Cybernetic-Enhancement-Technologies/transradial_development/ECAD/Altium/SoM BaseBoard Prototype V0/Project Outputs for Free Documents - Latest/BOM/Bill of Materials-SoM BaseBoard Prototype V0.xlsx

Line # | Name | Description | Designator | Revision ID | Revision State | Revision Status | Quantity | PartNumber | Part Number | Manufacturer_Part_Number | Manufacturer Part Number | Manufacturer 1 | Manufacturer Part Number 1 | Manufacturer Lifecycle 1 | Supplier 1 | Supplier Part Number 1 | Supplier Unit Price 1 | Supplier Subtotal 1
 | C0603X104K5RACTU | CAP CER 0.1UF 50V X7R 0603 | C1, C3, C6, C17, C18, C22, C25 | CMP-2006-03300-2 | New From Design | Up to date | 7 |  |  |  | C0603X104K5RACTU | KEMET | C0603X104K5RACTU | Volume Production | Digi-Key | 399-7969-1-ND | 0.149 | 4.17
 | GRM21BR60J226ME39L | Chip Multilayer Ceramic Capacitors for General Purpose, 0805, 22uF, X5R, 15%, 20%, 6.3V | C2, C7, C8 | CMP-2007-03385-2 | New From Design | Up to date | 3 |  |  |  |  | Murata | GRM21BR60J226ME39L | Not Recommended for New Design | Digi-Key | 490-1719-1-ND | 0.314 | 3.77
 | C0805C105K4PACTU |  | C4, C19, C24 | CMP-1036-04746-2 | Released | Up to date | 3 |  | C0805C105K4PACTU |  |  | TDK | C2012X7R1C105K/1.25 | End of Life | Arrow Electronics | C2012X7R1C105K/1.25 | 0.0979 | 1.17
 | GRM31CR60J476ME19L | Chip Multilayer Ceramic Capacitors for General Purpose, 1206, 47uF, X5R, 15%, 20%, 6.3V | C5 | CMP-2000-06344-2 | New From Design | Up to date | 1 |  |  |  |  | Murata | GRM31CR60J476ME19L | Not Recommended for New Design | Digi-Key | 490-3907-1-ND | 0.82 | 3.28
 | C2012X7R1A106K125AC | Multilayer Ceramic Chip Capacitor, 10 uF, +/- 10%, 10 V, -55 to 125 degC, 0805 (2012 Metric), RoHS, Tape and Reel | C9, C10, C12, C14, C15, C16, C23 | CMP-2000-05452-1 | Released | Up to date | 7 |  |  |  |  | TDK | C2012X7R1A106K125AC | Volume Production
 | ECA-1JHG471 | Aluminum Electrolytic Capacitor (Radial Lead Type), 470 uF, 63 V, -55 to 105 degC, 2-Pin THD, RoHS, Bulk | C11 | CMP-1665-00014-4 | Released | Up to date | 1 |  |  |  |  | Panasonic | ECA-1JHG471 | Volume Production | Allied Electronics | 70255904 | 0.887 | 88.7
 | UWX1E101MCL1GB | CAP ALUM 100UF 20% 25V SMD | C13 | CMP-12462-000012-1 | New From Design | Up to date | 1 |  |  |  |  | Nichicon | UWX1E101MCL1GB | Volume Production | Allied Electronics | 70409966 | 0.167 | 104.38
 | 06035C102KAT2A |  | C20, C21, C26, C27 | CMP-2006-04378-1 | Released | Up to date | 4 |  | 06035C102KAT2A |  |  | Kyocera AVX | 06035C102KAT2A | Volume Production | Digi-Key | 478-1215-1-ND | 0.045 | 0.72
 | SMBJ5.0A-TR | TVS DIODE 5V 13.4V SMB | D1 | CMP-12225-000019-1 | New From Design | Up to date | 1 |  |  |  | SMBJ5.0A-TR | STMicroelectronics | SMBJ5.0A-TR | Volume Production | Digi-Key | 497-3144-1-ND | 0.42 | 1.68
 | 210-P92-20GBEG | SOCKET 2X20 100-MIL STRAIGHT SMT | J1 |  | Not managed |  | 1 |  |  |  |  |  |  |  | Samtec | 210-P92-20GBEG
 | USB4085-GF-A | CONN RCPT USB2.0 TYPEC 16POS | J2, J3 | CMP-196119-000001-1 | New From Design | Up to date | 2 |  |  |  | USB4085-GF-A | Global Connector Technology | USB4085-GF-A | Volume Production | Digi-Key | 2073-USB4085-GF-ACT-ND | 0.94 | 7.52
 | 87520-0010BLF |  | J4 |  | Not managed |  | 1 |  |  |  |  | Amphenol ICC / FCI | 87520-0010BLF | Unknown | Digi-Key | 609-1045-ND | 0.84 | 3.36
 | 0.1 1x3 Header |  | J6, J7, J10, J11 |  | Not managed |  | 4
 | SJ1-3523N | Connector | J8, J12 |  | Not managed |  | 2 |  |  | SJ1-3523N |  | CUI | SJ1-3523N | Volume Production | Digi-Key | CP1-3523N-ND | 0.75 | 6
 | DF40HC(3.0)-100DS-0.4V(51) | CONN HDR 100POS 0.4MM SMD GOLD | J1310, J1311, J1312 |  | Not managed |  | 3 |  |  |  |  | Hirose | DF40C-100DP-0.4V(51) | Volume Production | Digi-Key | H11614CT-ND | 1.42 | 17.05
 | 2.2uH 1.7A | Inductor NRH2412T2R2MNGH | L1 |  | Not managed |  | 1 |  |  | NRH2412T2R2MNGH |  | Taiyo Yuden | NRH2412T2R2MNGH | Volume Production | Digi-Key | 587-3443-1-ND | 0.24 | 0.96
 | 150080SS75000 | SMD mono-color Chip LED, WL-SMCW, Super Red | LED1 | CMP-1426-00010-1 | Released | Up to date | 1 | 150080SS75000 |  |  |  | Wurth Electronics | 150080SS75000 | Volume Production | Digi-Key | 732-4985-1-ND | 0.18 | 0.72
 | 150080GS75000 | SMD mono-color Chip LED, WL-SMCW, Green | LED2 | CMP-1426-00007-1 | Released | Up to date | 1 | 150080GS75000 |  |  |  | Wurth Electronics | 150080GS75000 | Volume Production | Digi-Key | 732-4983-1-ND | 0.18 | 0.72
 | Servo Motor |  | M1, M2, M3, M4, M5, M6 |  | Not managed |  | 6
 | B2B-PH-SM4-TB(LF)(SN) | Male Header, Pitch 2 mm, 1 x 2 Position, Height 6.6 mm, RoHS, Tape and Reel | P1 | CMP-2000-05163-1 | Released | Up to date | 1 |  |  |  |  | JST | B2B-PH-SM4-TB(LF)(SN) | Volume Production
 | 5-146280-2 | Male Header, Pitch 2.54 mm, 1 x 2 Position, Height 8.21 mm, Tail Length 3.05 mm, -65 to 105 degC, RoHS, Bulk | P2 | CMP-2000-07492-1 | Released | Up to date | 1 |  |  |  |  | TE Connectivity | 5-146280-2 | Volume Production | Mouser | 571-5-146280-2 | 0.45 | 1.8
 | PMF250XNEX | MOSFET (N-Channel) | Q1, Q2 |  | Not managed |  | 2 |  |  | PMF250XNEX |  | Nexperia | PMF250XNEX | Unknown | Mouser | 771-PMF250XNEX | 0.262 | 2.62
 | RC0805FR-0710KL | Chip Resistor, 10 KOhm, +/- 1%, 0.125 W, -55 to 155 degC, 0805 (2012 Metric), RoHS, Tape and Reel | R1, R9, R12, R13, R15, R16, R21, R22, R27, R28, R31, R32, R33, R34, R35, R36, R37, R38 | CMP-1659-00013-4 | Released | Up to date | 18 |  |  |  |  | Yageo | RC0805FR-0710KL | Volume Production | Digi-Key | 311-10.0KCRCT-ND | 0.0169 | 1.69
 | CRCW08055K10FKEA | RES Thick Film, 5.1kΩ, 1%, 0.125W, 100ppm/°C, 0805 | R2, R4, R6, R7 | CMP-2001-04024-2 | New From Design | Up to date | 4 |  |  |  |  | Vishay | CRCW08055K10FKEA | Volume Production | Digi-Key | 541-5.10KCCT-ND | 0.067 | 1.07
 | RC0805FR-071KL | Chip Resistor, 1 KOhm, +/- 1%, 125 mW, -55 to 155 degC, 0805 (2012 Metric), RoHS, Tape and Reel | R3, R8 | CMP-2100-03671-1 | Released | Up to date | 2 |  |  |  |  | Yageo | RC0805FR-071KL | Volume Production | Digi-Key | 311-1.00KCRCT-ND | 0.042 | 0.42
 | RC1206JR-070RL | RES SMD 0 OHM JUMPER 1/4W 1206 | R5, R11, R17, R18, R25 | CMP-2100-03681-2 | New From Design | Up to date | 5 |  |  |  | RC1206JR-070RL | Yageo | RC1206JR-070RL | Volume Production | Digi-Key | 311-0.0ERCT-ND | 0.04 | 1
 | CRCW080520K0FKEA | RES Thick Film, 20kΩ, 1%, 0.125W, 100ppm/°C, 0805 | R10 | CMP-2001-03667-2 | New From Design | Up to date | 1 |  |  |  |  | Vishay | CRCW080520K0FKEA | Volume Production | Arrow Electronics | CRCW080520K0FKEA | 0.0998 | 0.3992
 | RC0603FR-07100KL | RES SMD 100K OHM 1% 1/10W 0603 | R19, R20, R23, R24, R26 | CMP-2100-03662-2 | Released | Up to date | 5 |  |  |  |  | Yageo | RC0603FR-07100KL | Volume Production | Digi-Key | 311-100KHRCT-ND | 0.024 | 0.48
 | KTS1681AEUZ-TR | Switch | S1 |  | Not managed |  | 1 |  |  | KTS1681AEUZ-TR |  | Kinetic Technologies | KTS1681AEUZ-TR | Unknown | Mouser | 389-KTS1681AEUZTR | 0.76 | 3.04
 | TestPad |  | TP1, TP2, TP3, TP4, TP5, TP6, TP7, TP8, TP9, TP10, TP11, TP12, TP13, TP14, TP15, TP16, TP17, TP18, TP19, TP20, TP21, TP22, TP23, TP24, TP25, TP26, TP27, TP28, TP29, TP30, TP31, TP32, TP33, TP34, TP35, TP36, TP37 |  | Not managed |  | 37
 | LM3671MF-3.3/NOPB | IC REG BUCK 3.3V 600MA SOT23-5 | U1 | CMP-0063-01132-4 | Released | Up to date | 1 |  |  |  |  | Texas Instruments | LM3671MF-3.3/NOPB | Volume Production | Mouser | 926-LM3671MF-3.3NOPB | 1.62 | 6.48
 | AP22653W6-7 | LOAD SWITCH,SOT26,T&R,3K | U2 | CMP-12749-000002-1 | New From Design | Up to date | 1 |  |  |  |  | Diodes | AP22653W6-7 | Unknown
 | ADS1015IDGST | IC ADC 12BIT SIGMA-DELTA 10VSSOP | U3 | CMP-0003-00377-3 | New From Design | Up to date | 1 |  |  |  |  | Texas Instruments | ADS1015IDGST | Volume Production
 | PCA9685PW,112 | 16-Channel, 12-Bit PWM Fm+ I2C-Bus LED Controller, 2.3 to 5.5 V, -40 to 85 degC, 28-Pin TSSOP (SOT361-1), RoHS, Tape and Reel | U4 | CMP-1595-00004-2 | Released | Up to date | 1 | PCA9685 |  |  |  | NXP Semiconductors | PCA9685PW,112 | Volume Production
 | NX5427001Z | Crystal or Oscillator | Y1 |  | Not managed |  | 1 |  |  | NX5427001Z |  | Diodes | NX5427001Z | Unknown | Digi-Key | NX5427001ZDICT-ND | 4.57 | 18.28
