Cybernetic-Enhancement-Technologies/transradial_development/(list of files, cad)

Other CAD files:
ECAD/Altium/SoM BaseBoard Prototype V0/Project Outputs for Free Documents - Latest/STEPandDXF Manual Exports/SoM BaseBoard Limbotics Prototype V0PcbDoc.DWG
