Cybernetic-Enhancement-Technologies/transradial_development/(threads)

Thread 4 (2021-03-25):

Add manual terminal event that can safely exit main program

jered-b, 2021-03-25:
https://github.com/Cybernetic-Enhancement-Technologies/transradial_development/blob/bbd427a37b41c3b04e2b4fbdbbd23f0511a7a25d/main_program.py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

jered-b, 2021-03-25:
Solved this using keyboard interrupt, pull request created.

Closed 2021-03-25.

Thread 10 (2021-03-27):

Add minimum number of frames across timespan of detection to qualify changing class attribute

jered-b, 2021-03-27:
https://github.com/Cybernetic-Enhancement-Technologies/transradial_development/blob/85f374cca53185f1cab10da0f46d26b2dd871e72/Camera_Interpreter/camera.py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

jered-b, 2021-04-06:
Instead going with simple time delay

Closed 2021-04-06.

Thread 9 (2021-03-27):

Add minimum number of detected frames over timespan before changing class attribute

jered-b, 2021-03-27:
https://github.com/Cybernetic-Enhancement-Technologies/transradial_development/blob/f93b8732a72df827598e175252912fcb6db20882/Camera_Interpreter/camera.py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

jered-b, 2021-03-27:
Accidentally opened, please check issue #10

Closed 2021-03-27.
