Cybernetic-Enhancement-Technologies/transradial_development/ECAD/Altium/SoM BaseBoard Prototype V0/Project Outputs for Free Documents - Latest/SoM BaseBoard Prototype V0.pdf

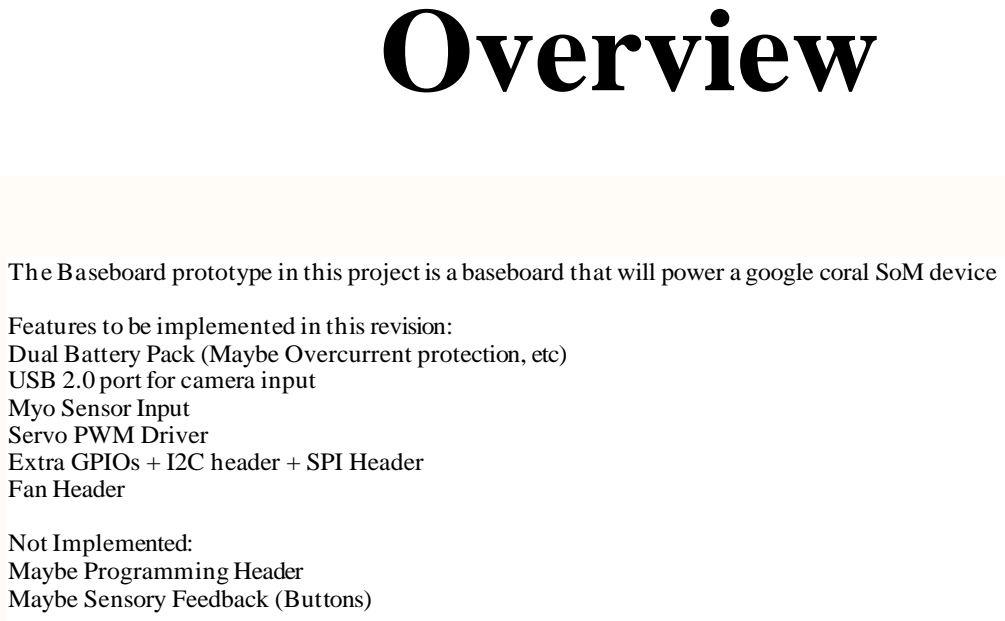
[picture p1: page 1]

DWG NO: | REV:

THIS DOCUMENT AND THE DATA DISCLOSED HEREIN OR HEREWITH IS THE PROPERTY OF ALTIUM LIMITED AND MAY BE FREELY DISTRIBUTED IN WHOLE. NO RIGHTS ARE RESERVED OR EXPRESS OR IMPLIED WARANTEE GIVEN. | | REVISION | DESCRIPTION | DATE | APPROVED

The Baseboard prototype in this project is a baseboard that will power a google coral SoM device

Features to be implemented in this revision:
Dual Battery Pack (Maybe Overcurrent protection, etc)
USB 2.0 port for camera input
Myo Sensor Input
Servo PWM Driver
Extra GPIOs + I2C header + SPI Header
Fan Header

Not Implemented:
Maybe Programming Header
Maybe Sensory Feedback (Buttons)

DATE | PROJECT | * * APPROVALS * *

ENG: *
CHK: * | | TITLE *

DSN: *

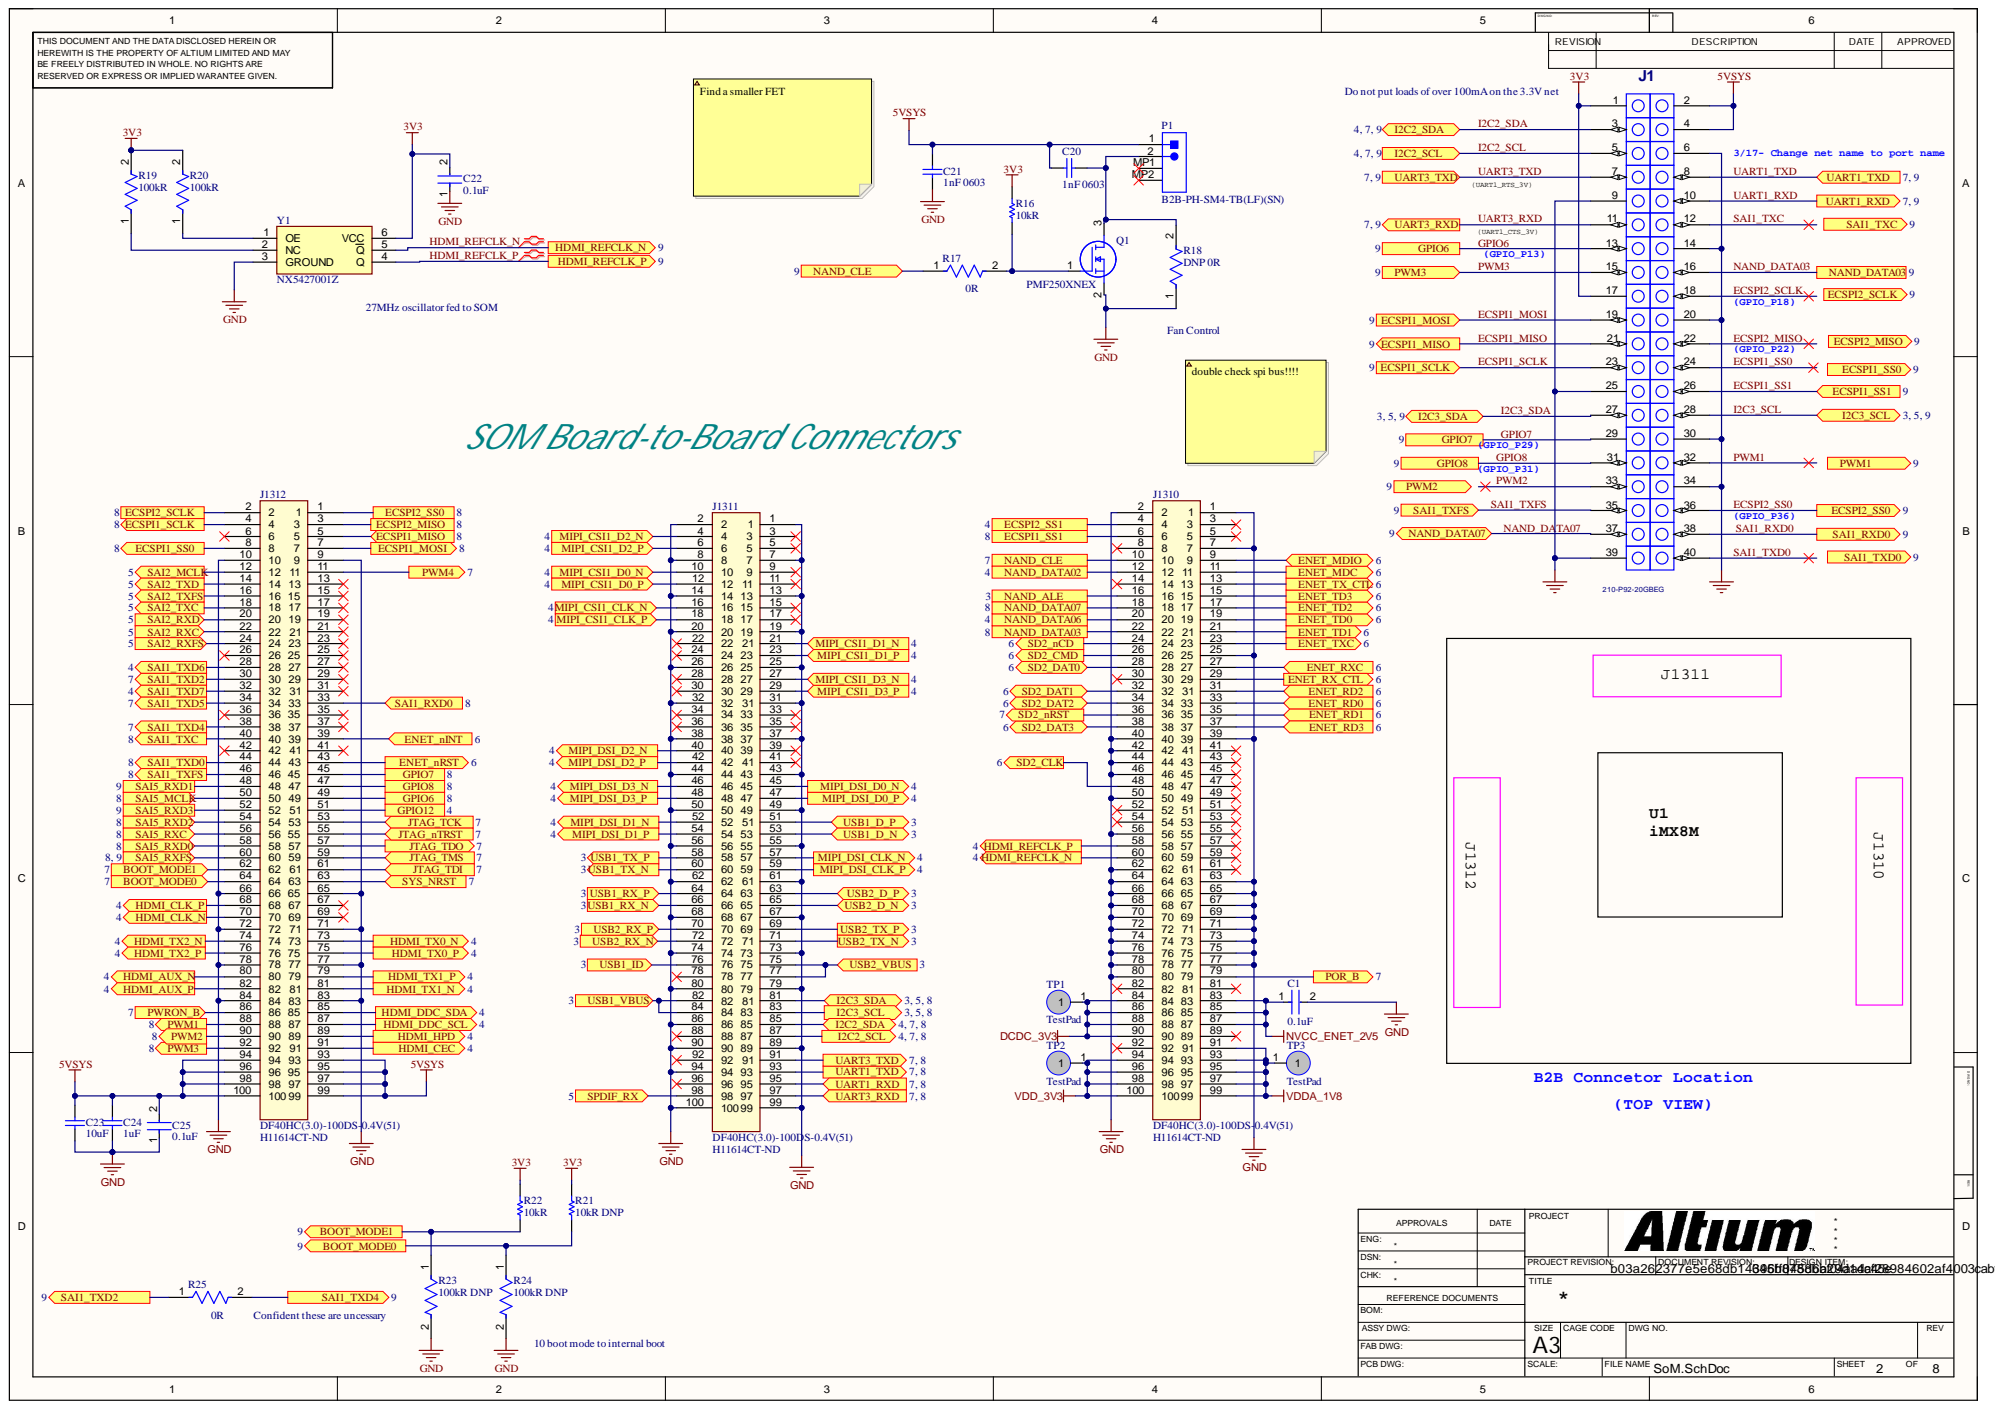
[picture p2: page 2]

RESERVED OR EXPRESS OR IMPLIED WARANTEE GIVEN.

Do not put loads of over 100mAon the 3.3V net

3/17- Change net name to port name
UART1_TXD

9 | | 10 | UART1_RXD

11 | | 12 | SAI1_TXC

27MHz oscillator fed to SOM

double check spi bus!!!!

27 | 28 | I2C3_SCL

SOM Board-to-Board Connectors

29 | 30 | PWM1

35 | 36
37 39 | 38 | (GPIO_P36) SAI1_RXD0

DATE | PROJECT | * * APPROVALS * *

ENG: *

Confident these are uncessary

10 boot mode to internal boot

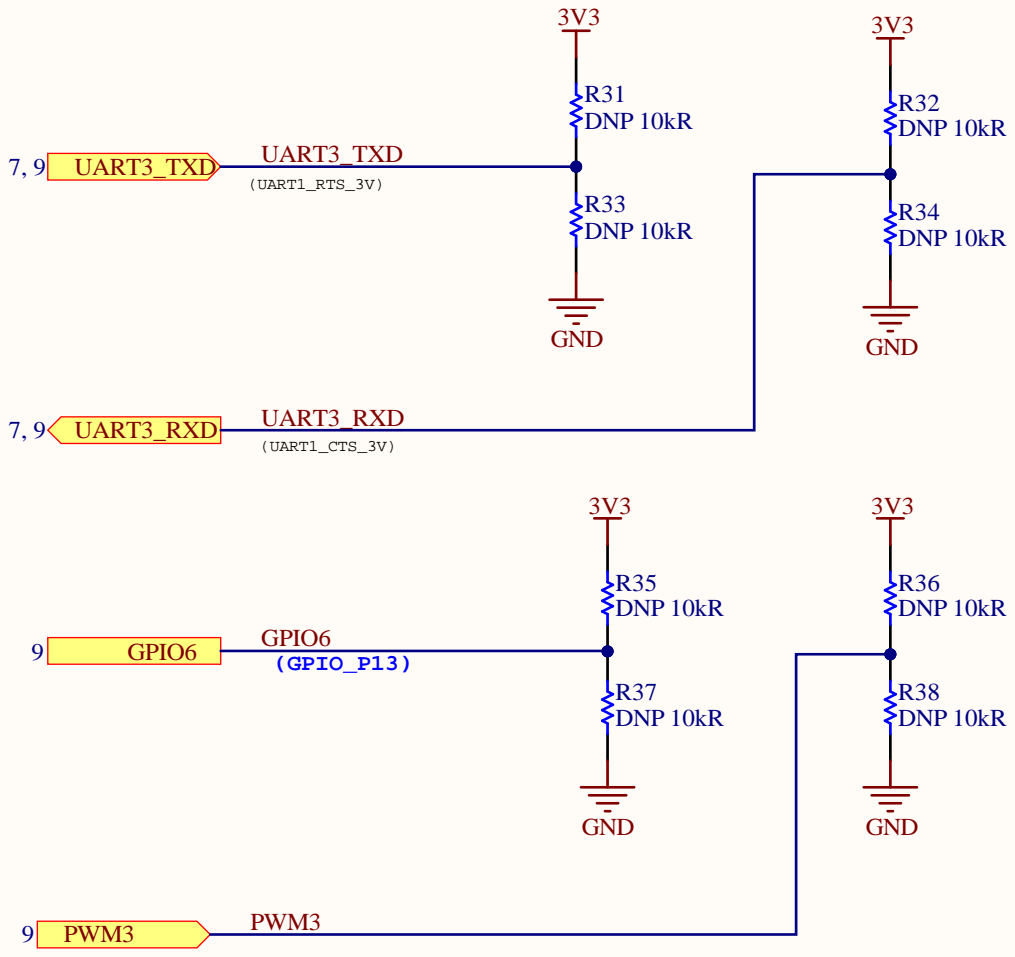
[picture p3: page 3]

RESERVED OR EXPRESS OR IMPLIED WARANTEE GIVEN.

DATE | PROJECT | * * APPROVALS * *

ENG: *
CHK: * | | TITLE *

DSN: *

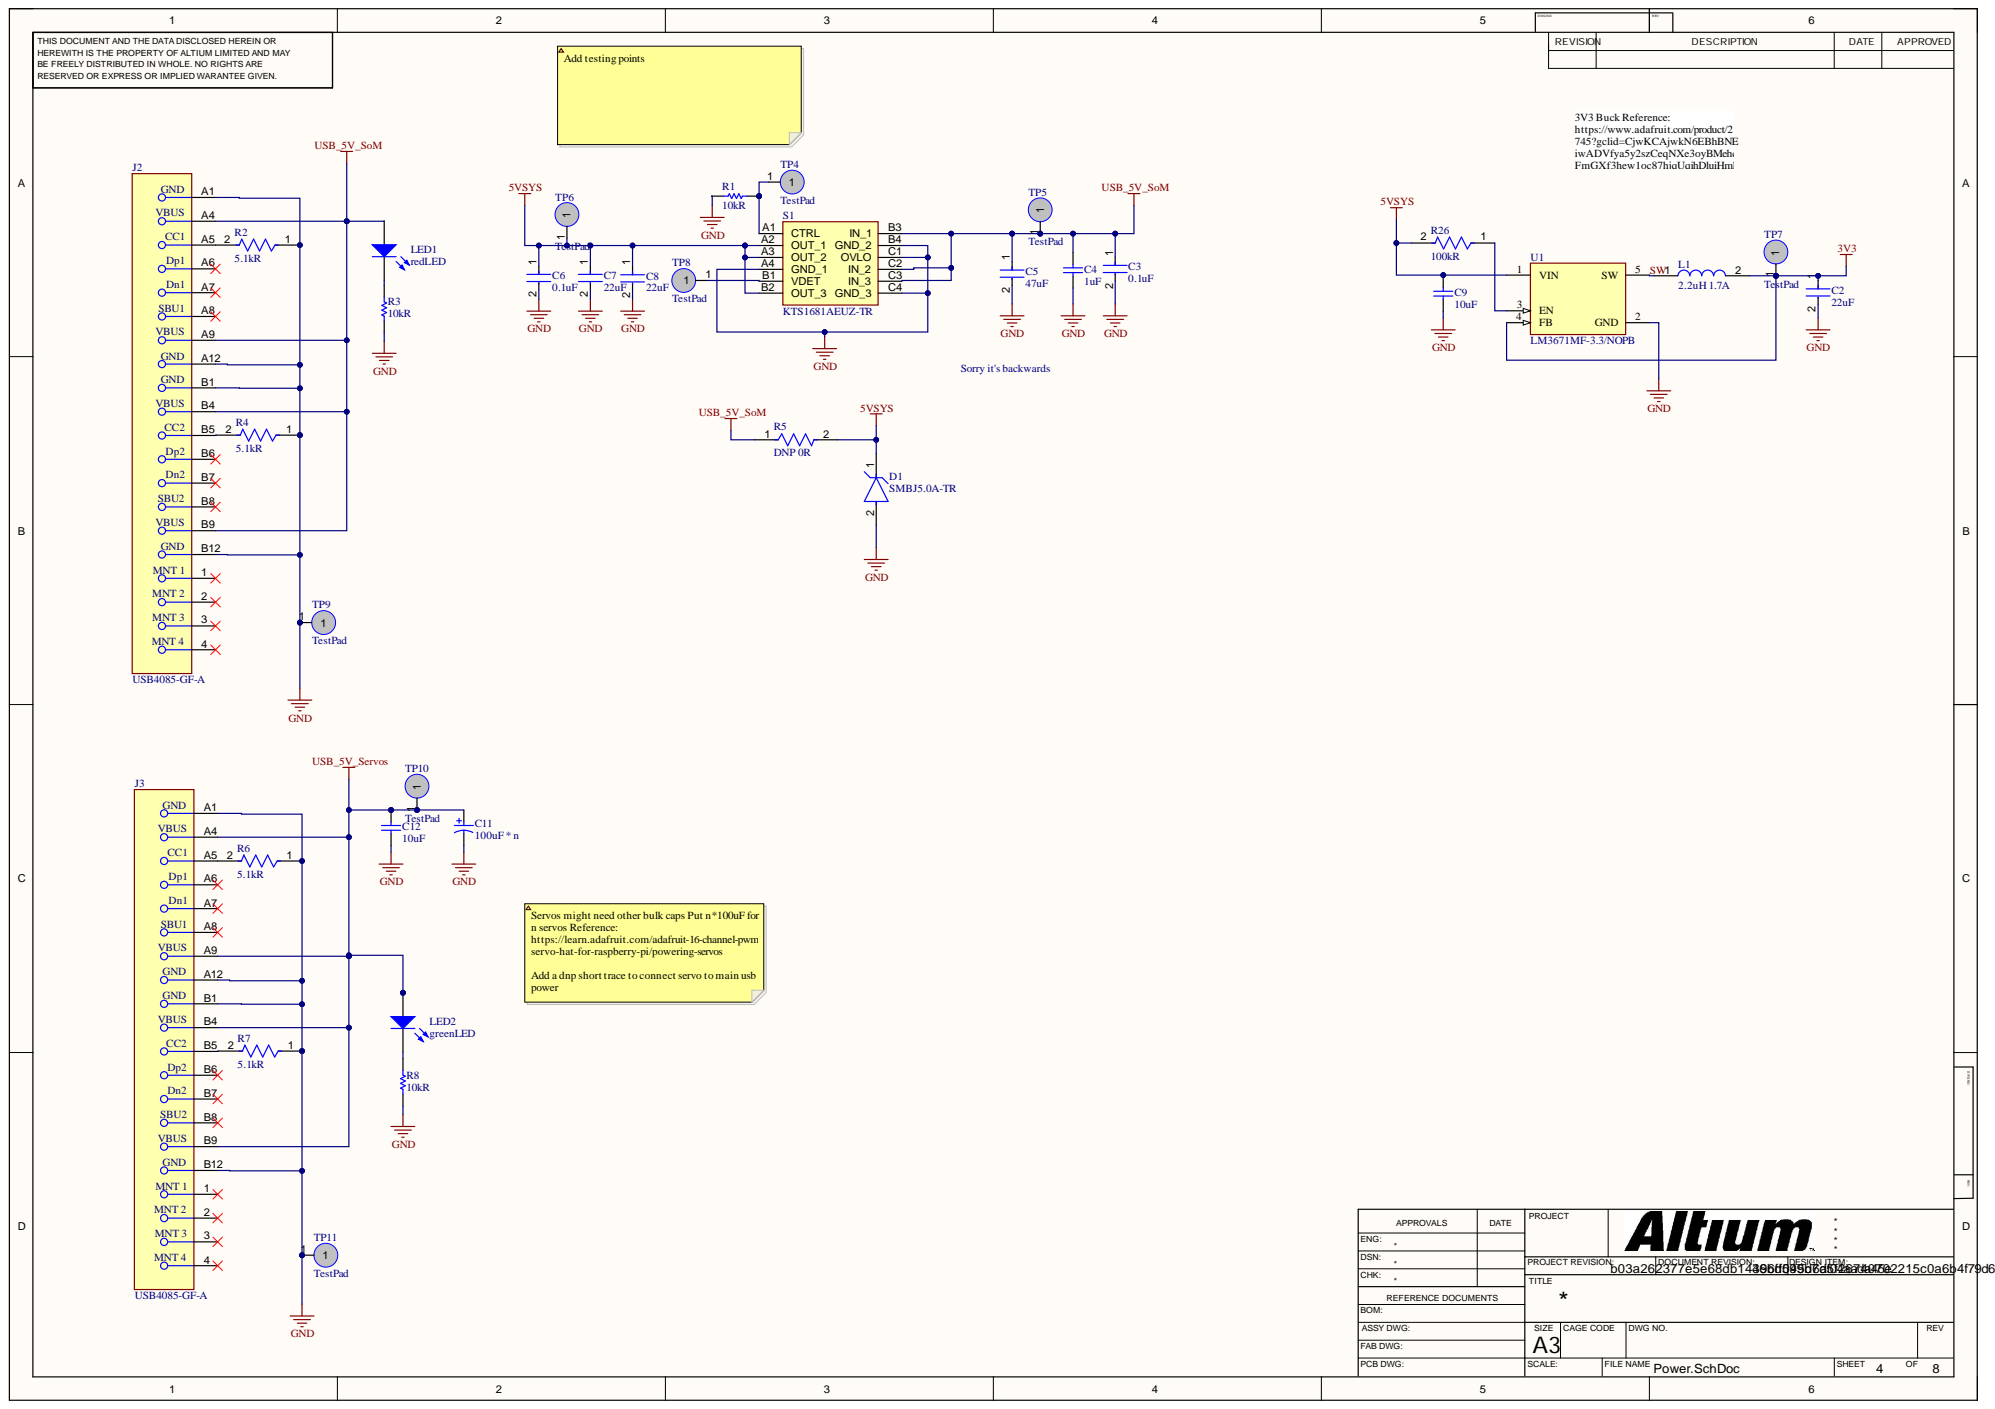
[picture p4: page 4]

RESERVED OR EXPRESS OR IMPLIED WARANTEE GIVEN.

Servos might need other bulk caps Put n*100uF for
n servos Reference:
https://learn.adafruit.com/adafruit-16-channel-pwm-
servo-hat-for-raspberry-pi/powering-servos

Add a dnp short trace to connectservo to main usb
power

DATE | PROJECT | * * APPROVALS * *

ENG: *
CHK: * | | TITLE *

DSN: *

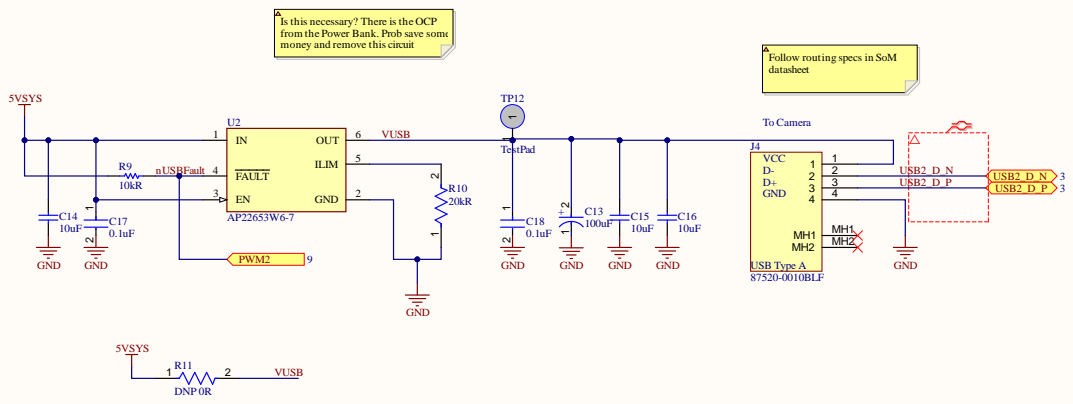
[picture p5: page 5]

RESERVED OR EXPRESS OR IMPLIED WARANTEE GIVEN.

Is this necessary? There is the OCP
from the Power Bank. Prob save some
money and remove this circuit

Follow routing specs in SoM
datasheet

DATE | PROJECT | * * APPROVALS * *

ENG: *
CHK: * | | TITLE *

DSN: *

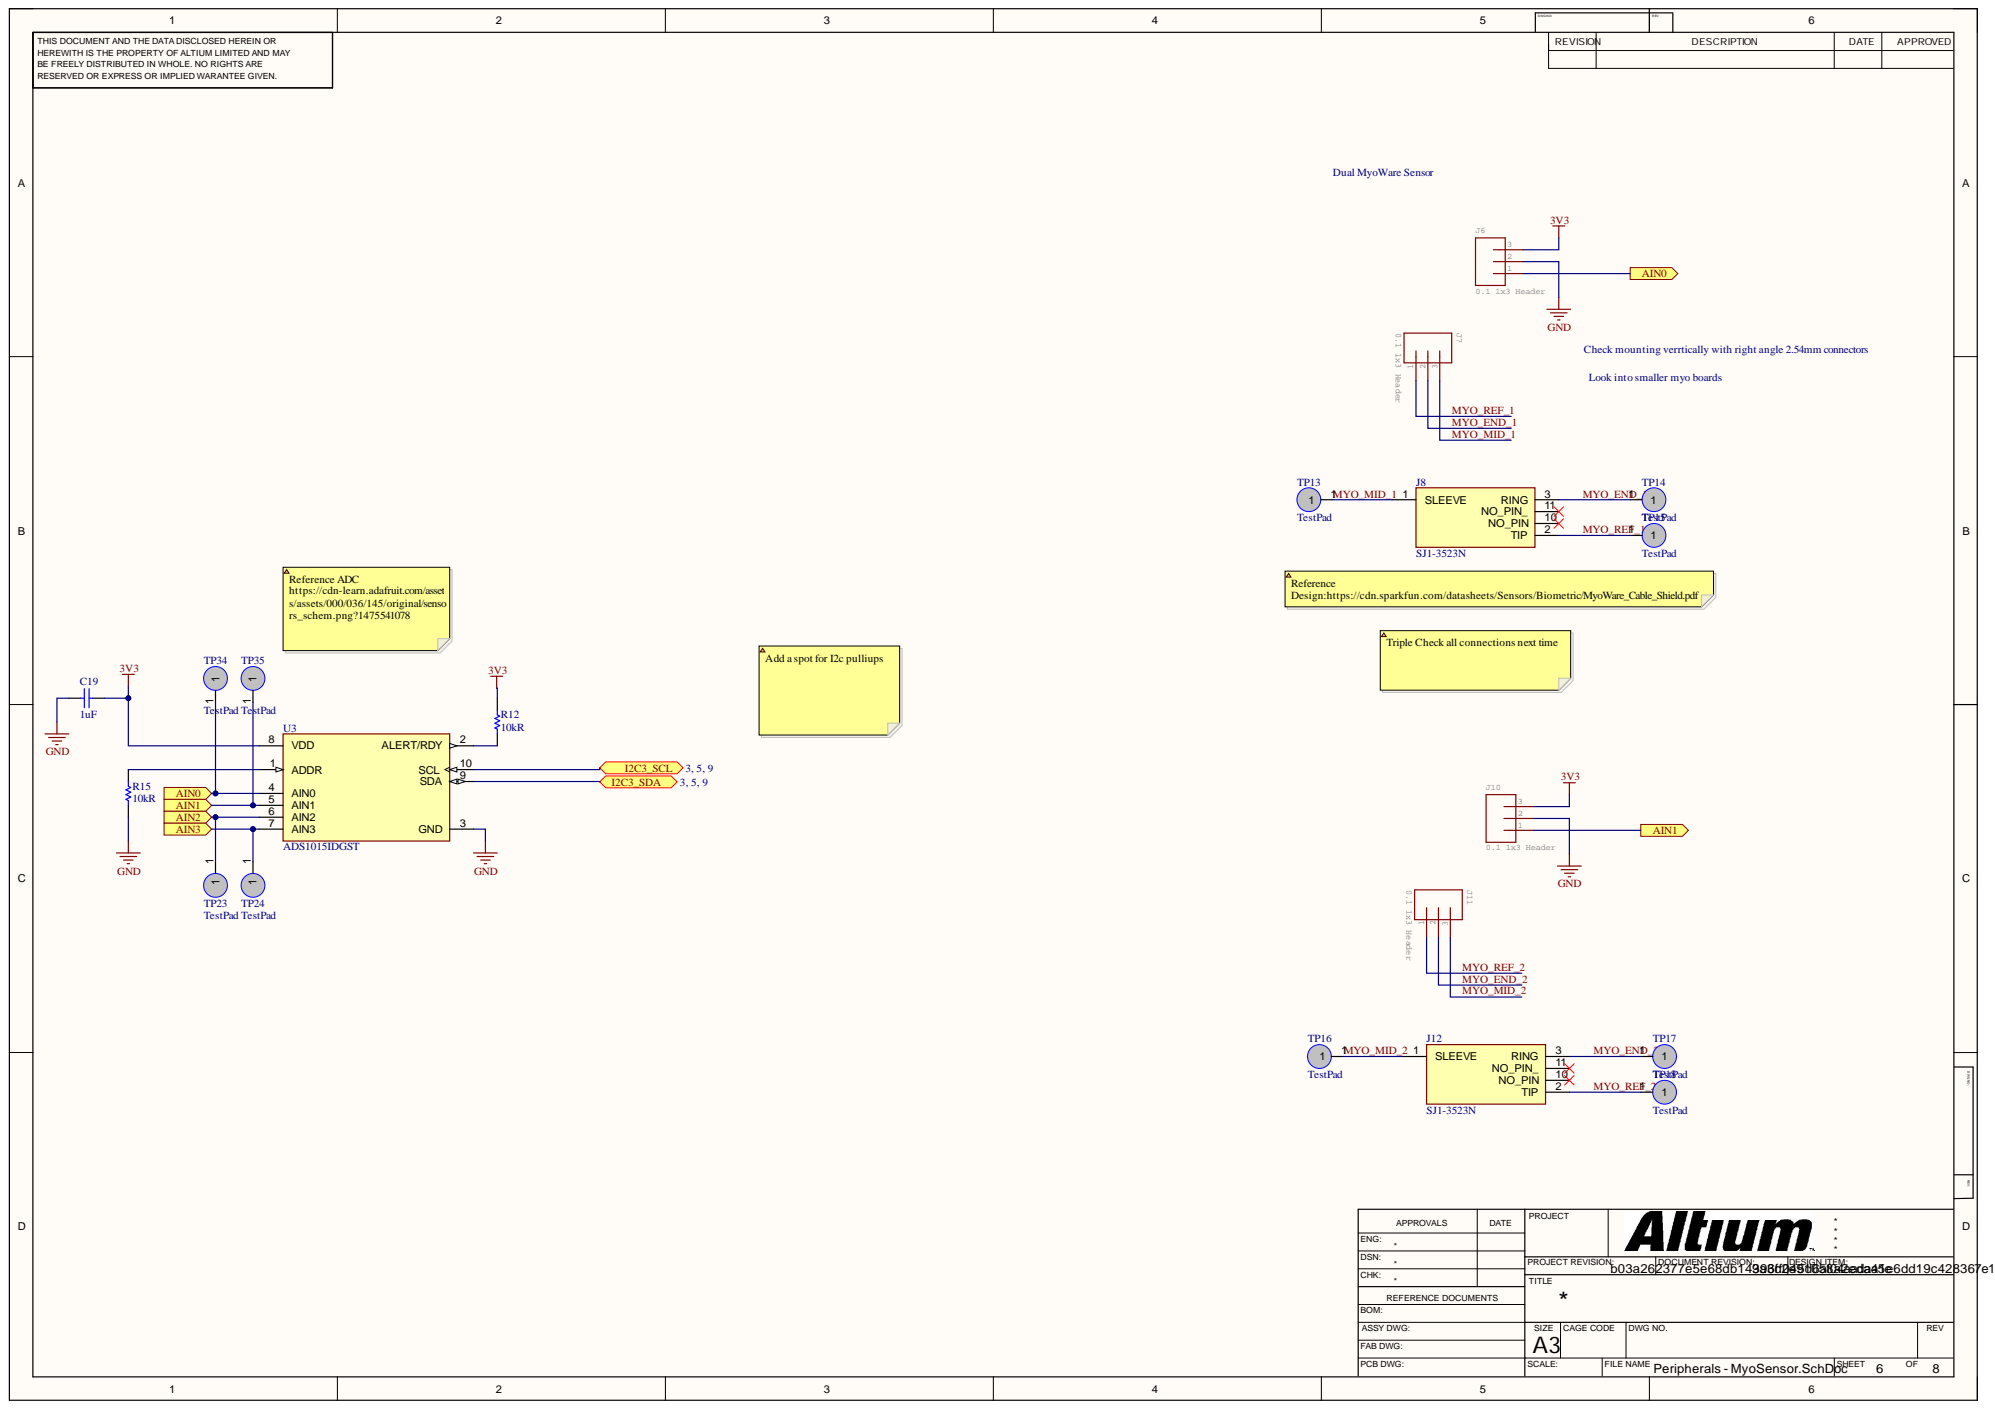
[picture p6: page 6]

RESERVED OR EXPRESS OR IMPLIED WARANTEE GIVEN.

Check mounting verrtically with right angle 2.54mm connectors

Look into smaller myo boards

Reference ADC
https://cdn-learn.adafruit.com/asset
s/assets/000/036/145/original/senso
rs_schem.png?1475541078

Reference
Design:https://cdn.sparkfun.com/datasheets/Sensors/Biometric/MyoWare_Cable_Shield.pdf

Triple Check all connections next time

Add a spot for I2c pulliups

DATE | PROJECT | * * APPROVALS * *

ENG: *
CHK: * | | TITLE *

DSN: *

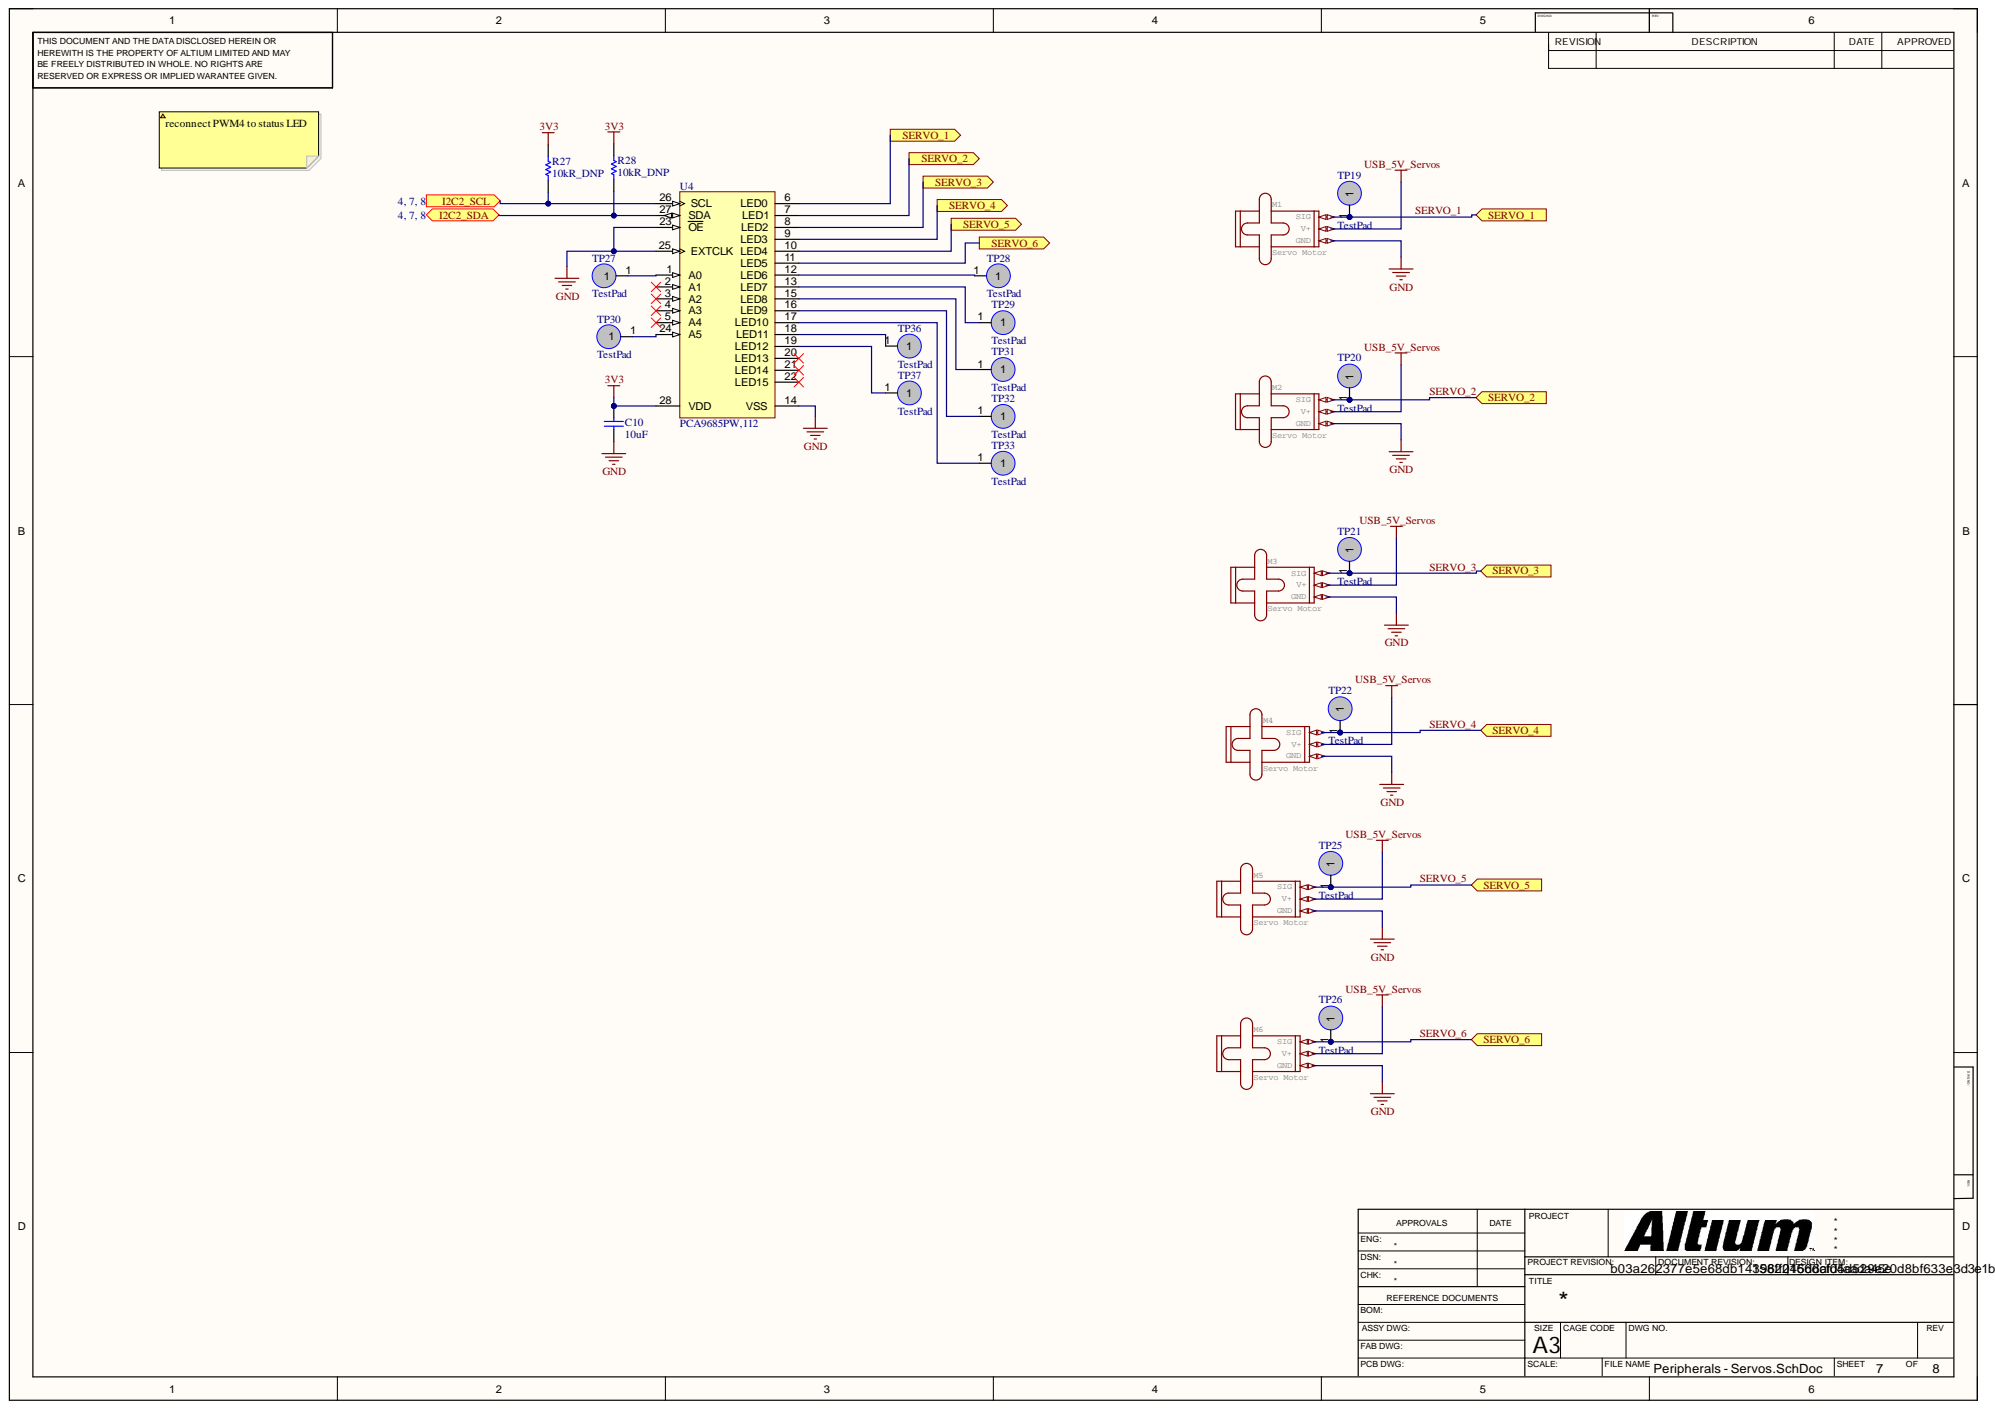
[picture p7: page 7]

RESERVED OR EXPRESS OR IMPLIED WARANTEE GIVEN.

reconnect PWM4 to status LED

DATE | PROJECT | * * APPROVALS * *

ENG: *
CHK: * | | TITLE *

DSN: *

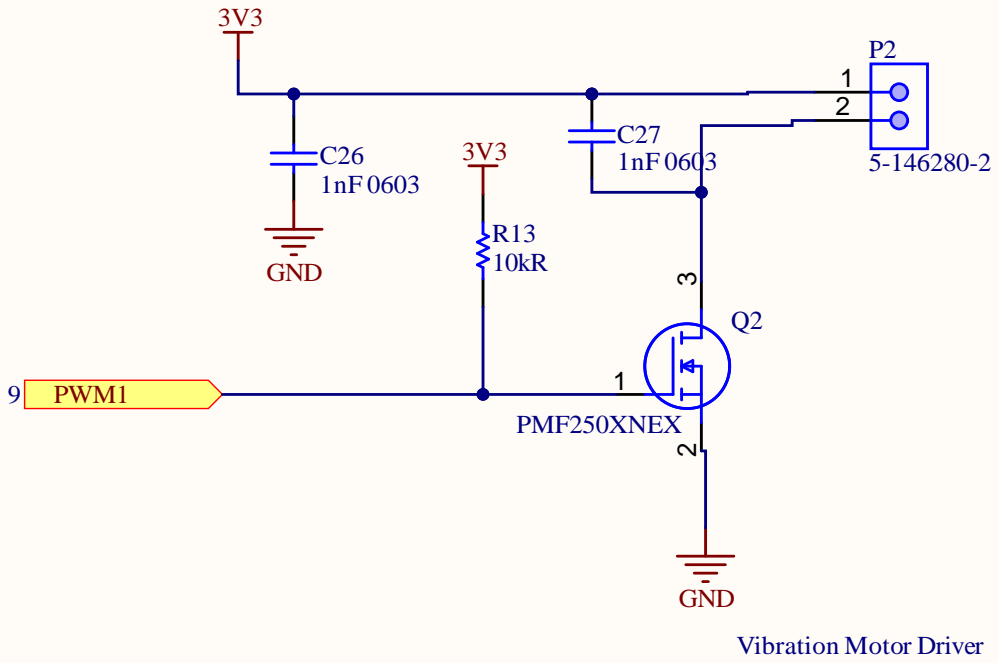
[picture p8: page 8]

THIS DOCUM ENT AND THE DATA DISCLOS ED HEREIN OR HERE WITH IS THE PROP ERT Y OF A LTIUM LIMIT ED AND M AY B E FRE E LY DIS TRIBUT ED IN WHOL E. NO RIGHT S ARE RE S ERV ED OR E X PRE S S OR IM P LIED W ARANT E E GIV EN. | | R E V I S I O | N D E S C R I P T I O N | D A T E | A P P R O V E D

A P PROV A L S | DAT E | PROJECT | ****

ENG: **
CHK : | | TIT L E *

DSN: | | PROJECT RE VISION: b 0 3 a 2 6 | DOCUM ENT RE VISION: 2 3 7 7 e 5 e 6 8 d b 1 4 53 89 86 bff0e | DE SIGN IT E M : c4f05d567a2f 03 4d a7acdda6465ee5 c 4 c b 8 3 e 6

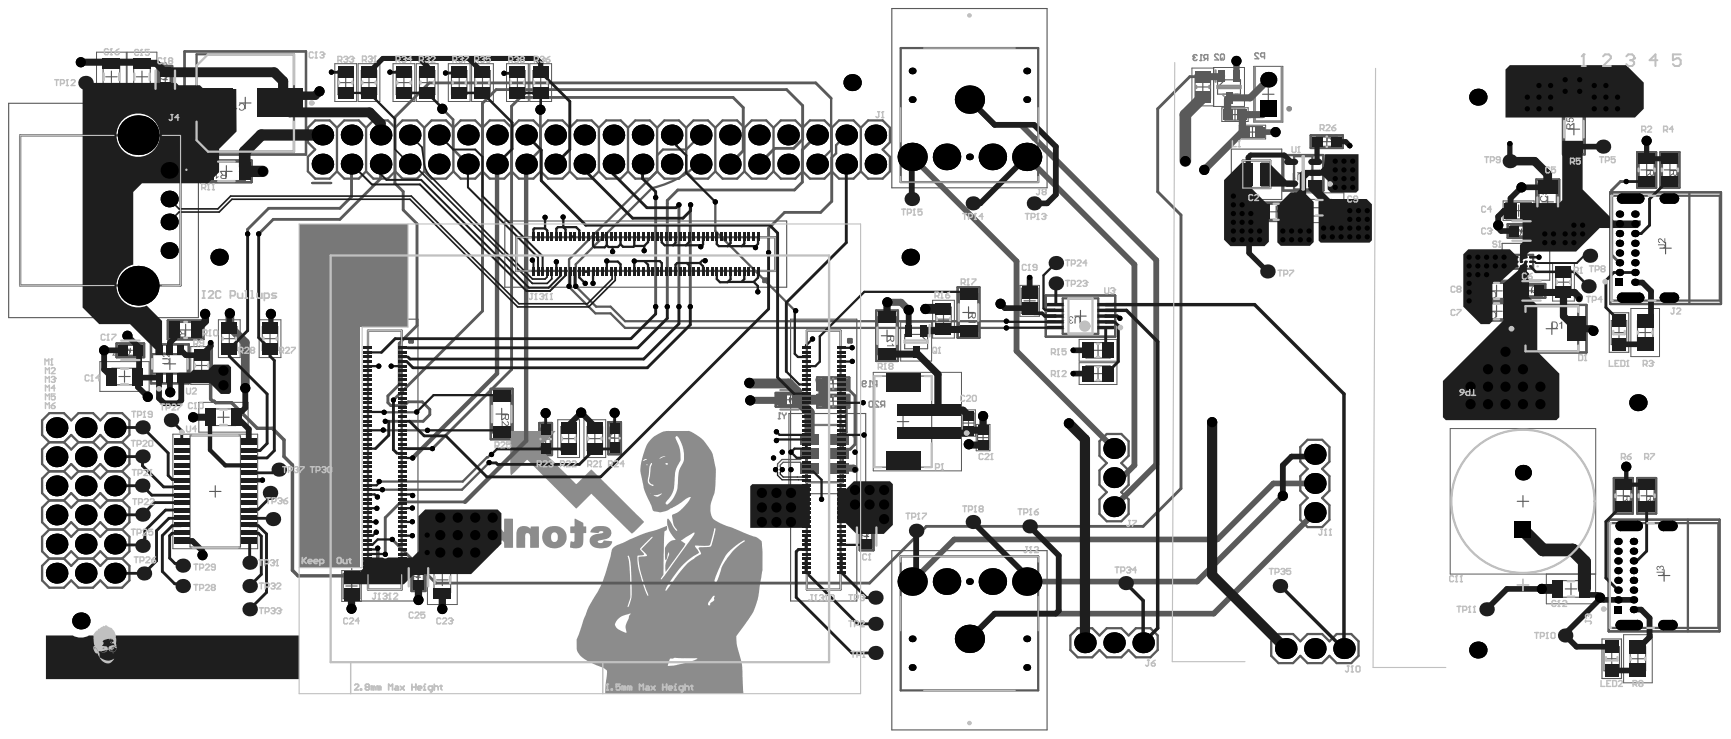
[picture p9: page 9]
