Cybernetic-Enhancement-Technologies/transradial_development/ECAD/Altium/SoM BaseBoard Prototype V0/Project Outputs for Free Documents - Latest/Assembly Drawings.pdf

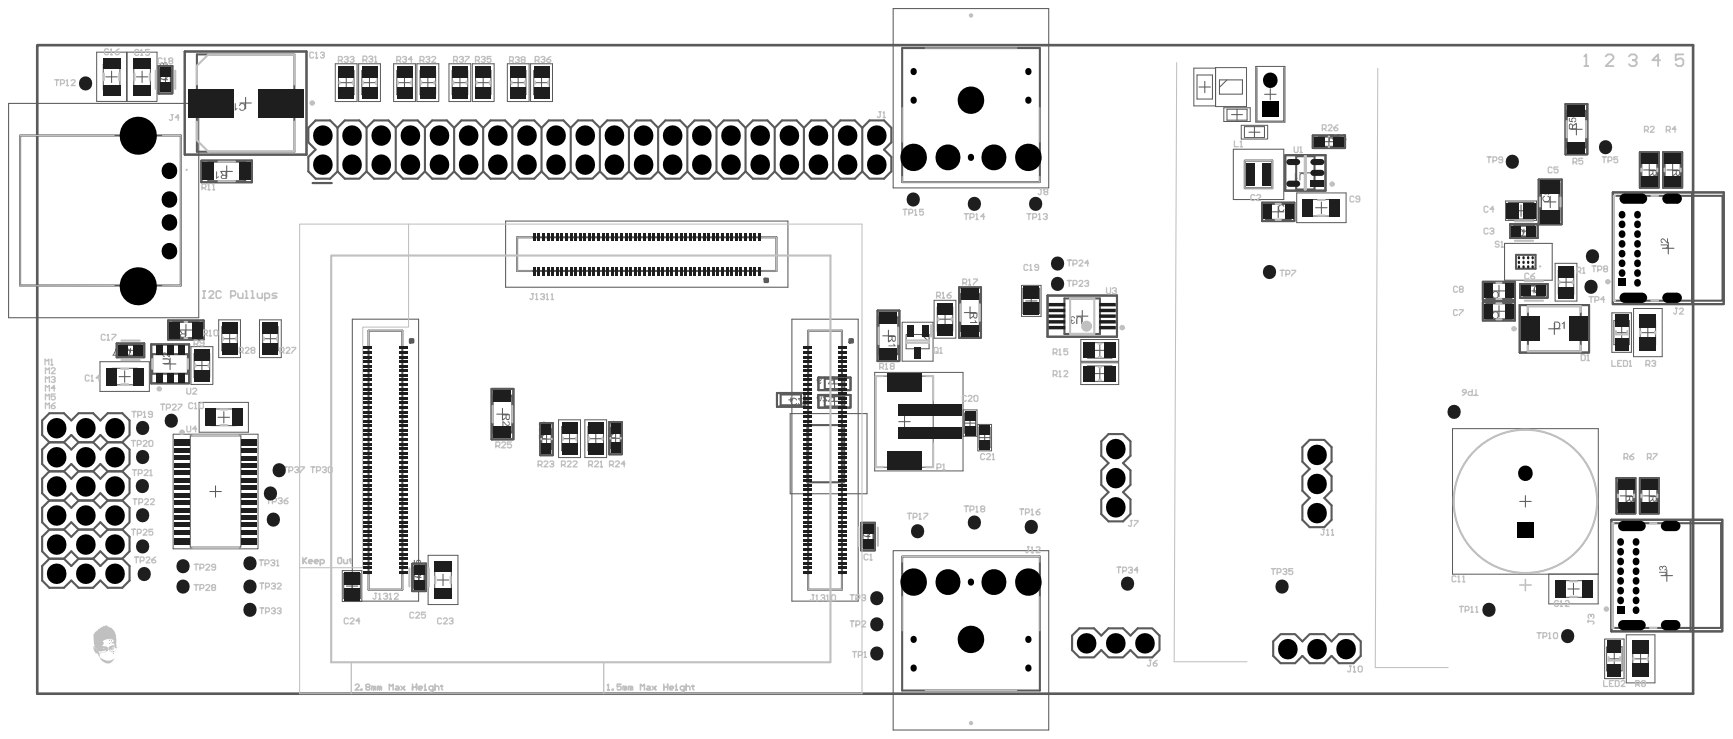
[picture p10: page 1]

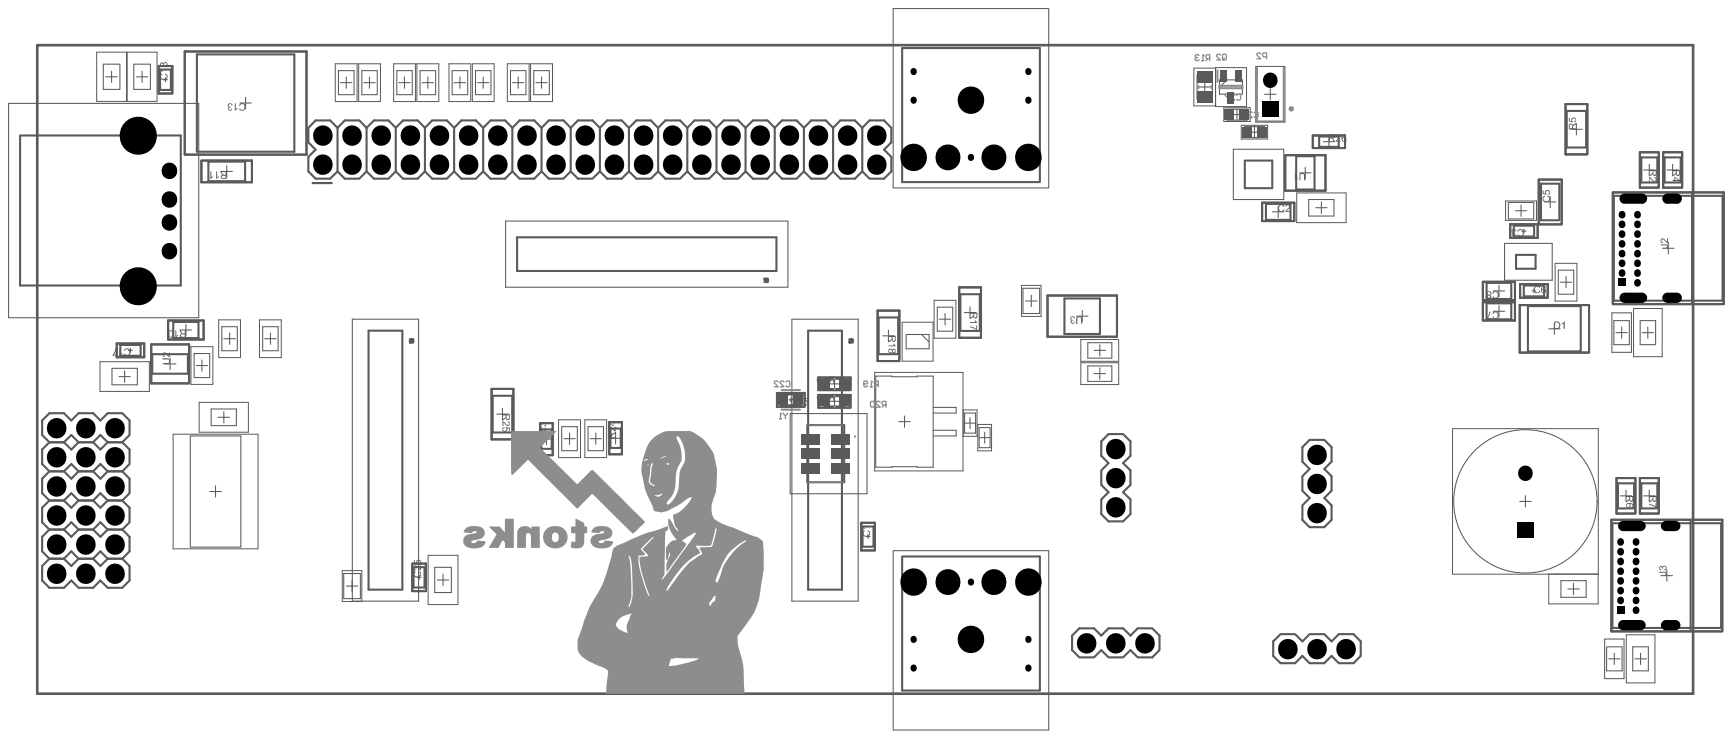
[picture p11: page 2]
