Cybernetic-Enhancement-Technologies/transradial_development/(list of files, drawings)

Other design files:
ECAD/Altium/SoM BaseBoard Prototype V0/Overview.SchDoc
ECAD/Altium/SoM BaseBoard Prototype V0/Peripherals - Feature Creep.SchDoc
ECAD/Altium/SoM BaseBoard Prototype V0/Peripherals - MyoSensor.SchDoc
ECAD/Altium/SoM BaseBoard Prototype V0/Peripherals - Servos.SchDoc
ECAD/Altium/SoM BaseBoard Prototype V0/Peripherals - USB.SchDoc
ECAD/Altium/SoM BaseBoard Prototype V0/Power.SchDoc
ECAD/Altium/SoM BaseBoard Prototype V0/SoM - PullUp PullDown.SchDoc
ECAD/Altium/SoM BaseBoard Prototype V0/SoM BaseBoard Limbotics Prototype V0PcbDoc.PcbDoc
ECAD/Altium/SoM BaseBoard Prototype V0/SoM BaseBoard Prototype V0.PrjPcb
ECAD/Altium/SoM BaseBoard Prototype V0/SoM.SchDoc
