Cybernetic-Enhancement-Technologies/transradial_development/(commit log)

2021-05-16 Backing up EE progress
    backing up schematics and layout
    [Overview.SchDoc, Peripherals - MyoSensor.SchDoc, Peripherals - USB.SchDoc, Power.SchDoc, SoM BaseBoard Limbotics Prototype V0PcbDoc.PcbDoc, SoM.SchDoc]
2021-06-29 Cleaned up and updated Altium files
    getting some design in
    [Peripherals - MyoSensor.SchDoc, Peripherals - Servos.SchDoc, SoM BaseBoard Limbotics Prototype V0PcbDoc.PcbDoc]
2021-07-10 tightening layout
    [SoM BaseBoard Limbotics Prototype V0PcbDoc.PcbDoc, SoM BaseBoard Prototype V0.PrjPcb]
2021-07-11 added pullup/ pulldowns
    also made layout better
    [Peripherals - USB.SchDoc, SoM - PullUp PullDown.SchDoc, SoM BaseBoard Limbotics Prototype V0PcbDoc.PcbDoc, SoM BaseBoard Prototype V0.PrjPcb]
2021-07-12 backing up
    changing stackup for impedance match
    [Peripherals - MyoSensor.SchDoc, Peripherals - Servos.SchDoc, Peripherals - USB.SchDoc, SoM - PullUp PullDown.SchDoc, SoM BaseBoard Limbotics Prototype V0PcbDoc.PcbDoc]
2021-07-12 did more work
    commit backup real quick
    [SoM BaseBoard Limbotics Prototype V0PcbDoc.PcbDoc, SoM.SchDoc]
2021-07-13 Finished Routing more signals
    USB for camera routed at 90Ohm, I2C for Servos routed, Servo Power routed, a couple GPIO routed. looking good
    [Peripherals - MyoSensor.SchDoc, SoM BaseBoard Limbotics Prototype V0PcbDoc.PcbDoc]
2021-07-13 Finished Power Layout
    Power components are laid out, just need to do mid power plane for 3V3. First doing signals
    [Peripherals - MyoSensor.SchDoc, SoM BaseBoard Limbotics Prototype V0PcbDoc.PcbDoc]
2021-07-13 Adding Step File
    added step file
    [SoM BaseBoard Limbotics Prototype V0PcbDoc.PcbDoc]
2021-07-13 Update SoM BaseBoard Prototype V0.PrjPcb
    updating the file structure
    [SoM BaseBoard Prototype V0.PrjPcb]
2021-07-13 Finished Core Layout
    Board is 100% Functional. Adding bonus features and cleaning up now
    [SoM BaseBoard Limbotics Prototype V0PcbDoc.PcbDoc]
2021-07-13 Adding Gerbers
    Added Gerbers for Output
    [SoM BaseBoard Prototype V0.PrjPcb]
2021-07-13 added some finishing touches 90% complete
    layout needs a bit more fine tuning but the core is done
    [SoM BaseBoard Limbotics Prototype V0PcbDoc.PcbDoc]
2021-07-14 finalized design
    added asthetics and ran DRC. Still need to output Gerbers and new Step w Mounting holes
    [SoM BaseBoard Prototype V0.PrjPcb, SoM.SchDoc]
2021-07-14 updated step file
    added buzzer to board
    [Copy of Bill of Materials-SoM BaseBoard Prototype V0.xlsx, Peripherals - Feature Creep.SchDoc, SoM BaseBoard Prototype V0.PrjPcb]
2021-07-14 updating BoM
    [Copy of Bill of Materials-SoM BaseBoard Prototype V0.xlsx, SoM BaseBoard Prototype V0.PrjPcb]
2021-07-18 small changes to BoM
    [SoM BaseBoard Prototype V0.PrjPcb]
2021-07-20 finalized links for ActiveBOM
    [Copy of Bill of Materials-SoM BaseBoard Prototype V0.xlsx]
2021-07-20 Final Board Commit
    Layout is finished and reviewed
    [Copy of Bill of Materials-SoM BaseBoard Prototype V0.xlsx, Peripherals - USB.SchDoc, SoM BaseBoard Prototype V0.PrjPcb, SoM.SchDoc]
2021-07-23 adding exports
    [Bill of Materials-SoM BaseBoard Prototype V0.xlsx]
2021-07-24 inverted the godman layers
    followed an obscure thread and the gertber editor is awful
2021-07-26 Dont look here
    i forgot the NC Drill file, please use this for manufacturing
2021-08-13 added 3d exports of latest ecad board
    [SoM BaseBoard Limbotics Prototype V0PcbDoc.DWG]
